errorcodexero/CartBot/CartBot.pdf

## CHASSIS

## PANEL

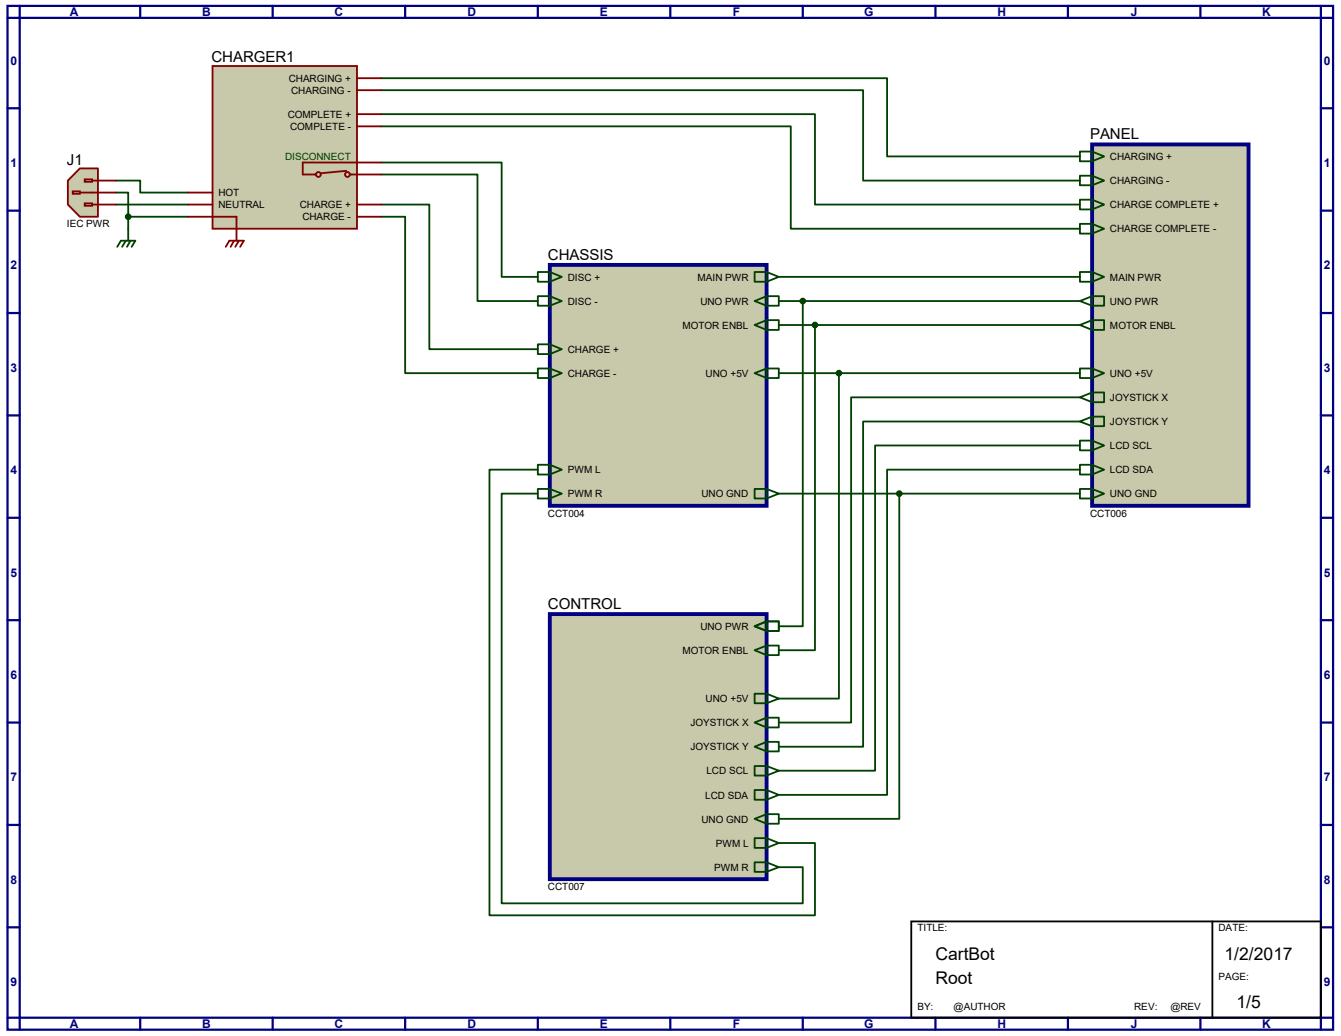
[picture p1: page 1]
TITLE:; DATE:; PAGE:; CartBot Root; @AUTHOR; REV: @REV; CCT004; MAIN PWR; UNO PWR; MOTOR ENBL; CCT006; JOYSTICK X; JOYSTICK Y; LCD SDA; LCD SCL; UNO GND; UNO +5V; CHARGING -; CHARGE COMPLETE +; CHARGE COMPLETE -; CHARGING +; CONTROL; CCT007; IEC PWR; DISCONNECT; CHARGE -; CHARGE +; HOT NEUTRAL; CHARGING + CHARGING -; COMPLETE + COMPLETE -; CHARGER1; DISC +; DISC -; PWM L; PWM R

U1

U2

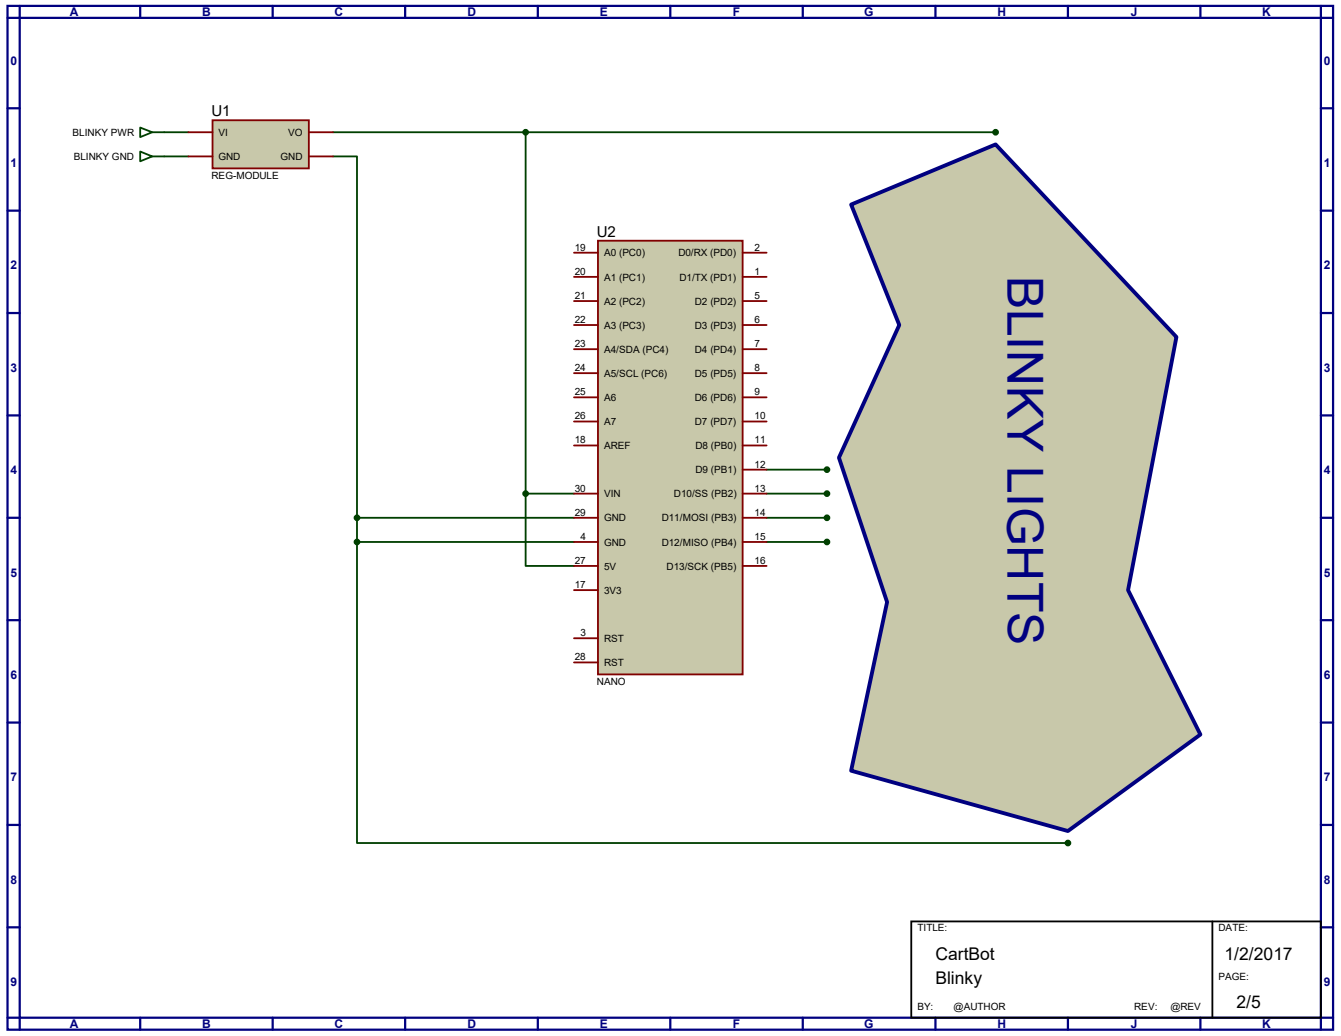
[picture p2: page 2]

## BAT1

FU1

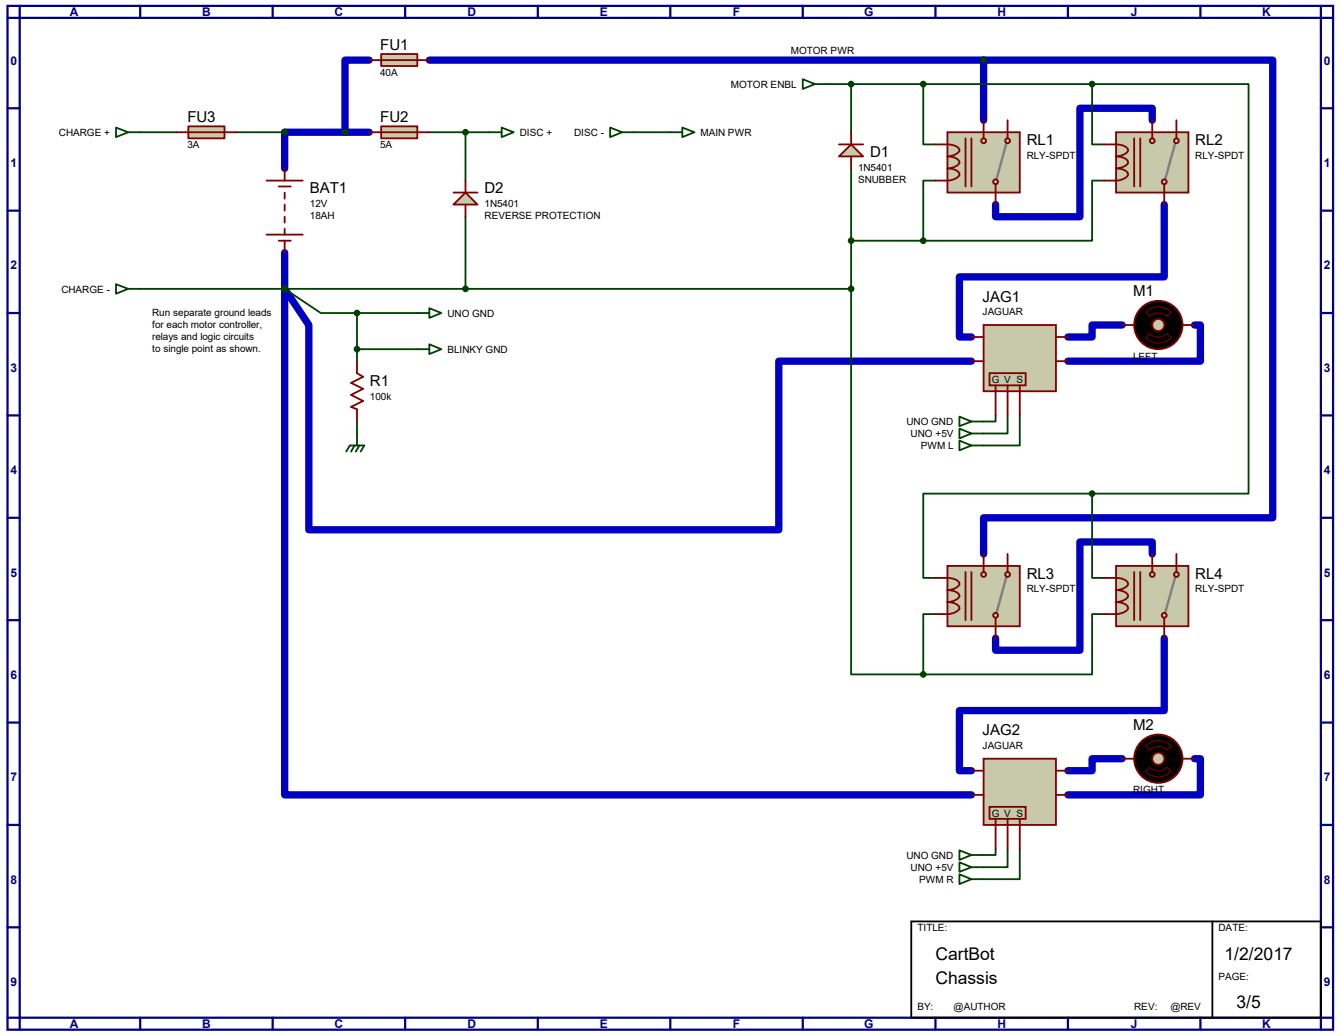
[picture p3: page 3]
TITLE:; DATE:; Chassis; @AUTHOR; REV: @REV; MOTOR PWR; RLY-SPDT; JAG1; JAGUAR; JAG2; 1N5401 SNUBBER; LEFT; RIGHT; 1N5401 REVERSE PROTECTION; UNO GND; BLINKY GND; MAIN PWR; MOTOR ENBL; UNO GND UNO +5V PWM L; UNO GND UNO +5V PWM R; CHARGE +; DISC +; DISC -; CHARGE -

Run separate ground leads
for each motor controller,
relays and logic circuits
to single point as shown.

JS1

JS2

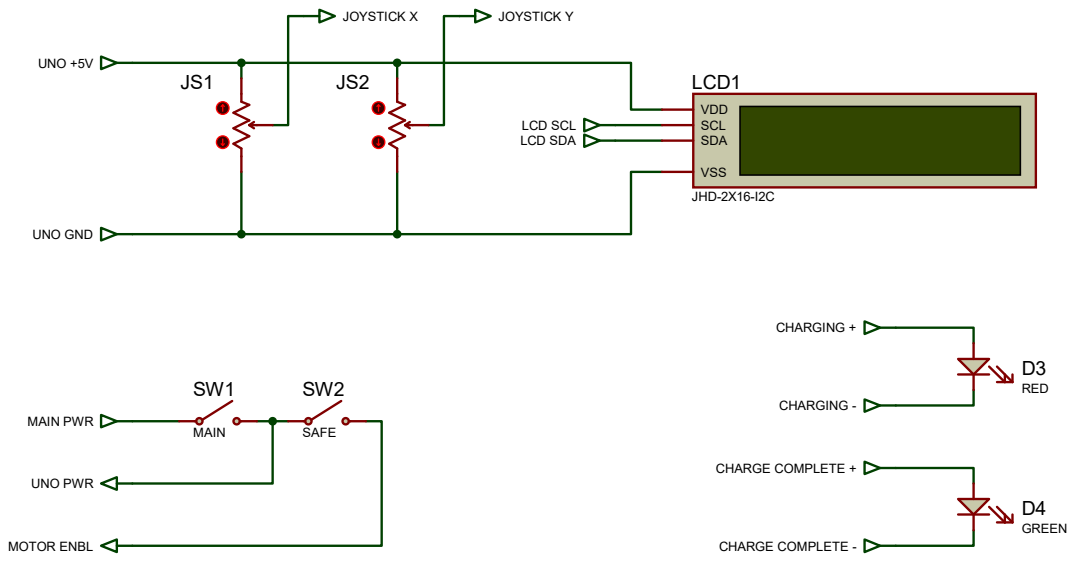
[picture p4: page 4]
TITLE:; DATE:; Panel; @AUTHOR; REV: @REV; UNO GND; UNO +5V; JOYSTICK X; JOYSTICK Y; VSS; SCL; VDD; SDA; LCD1; JHD-2X16-I2C; LCD SCL LCD SDA; RED; GREEN; CHARGING +; CHARGING -; CHARGE COMPLETE +; CHARGE COMPLETE -; MAIN; SAFE; MAIN PWR; UNO PWR; MOTOR ENBL

R2

R4

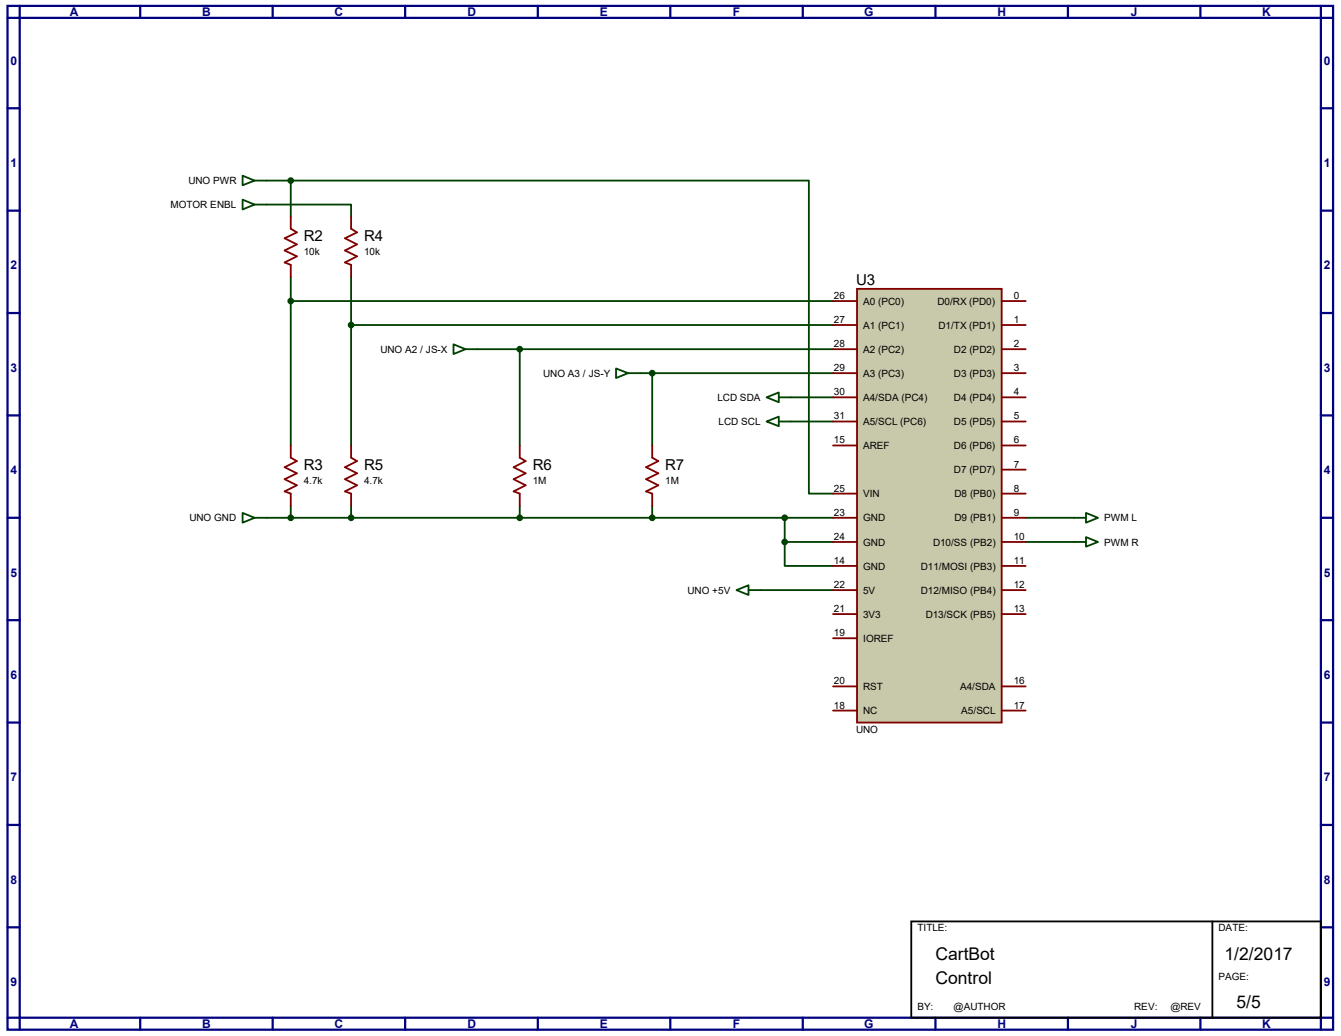
[picture p5: page 5]
