errorcodexero/CartBot/(list of files, drawings)

Other design files:
CartBot2.pdsprj
CartBot.pdsprj
