errorcodexero/CartBot/(commit log)

2017-06-06 now back to the spec
    [Battery A2D conversion.xlsx, CartBot.pdsprj, CartBot1.pdsprj, CartBot2.pdsprj]
2017-06-07 first working release
    [Battery A2D conversion.xlsx]
2017-06-09 software works, cleaning up schematics
    [CartBot1.pdsprj, CartBot2.pdsprj]
